MaximeChretien/HerbBox2.0/schematics/schematics.pdf

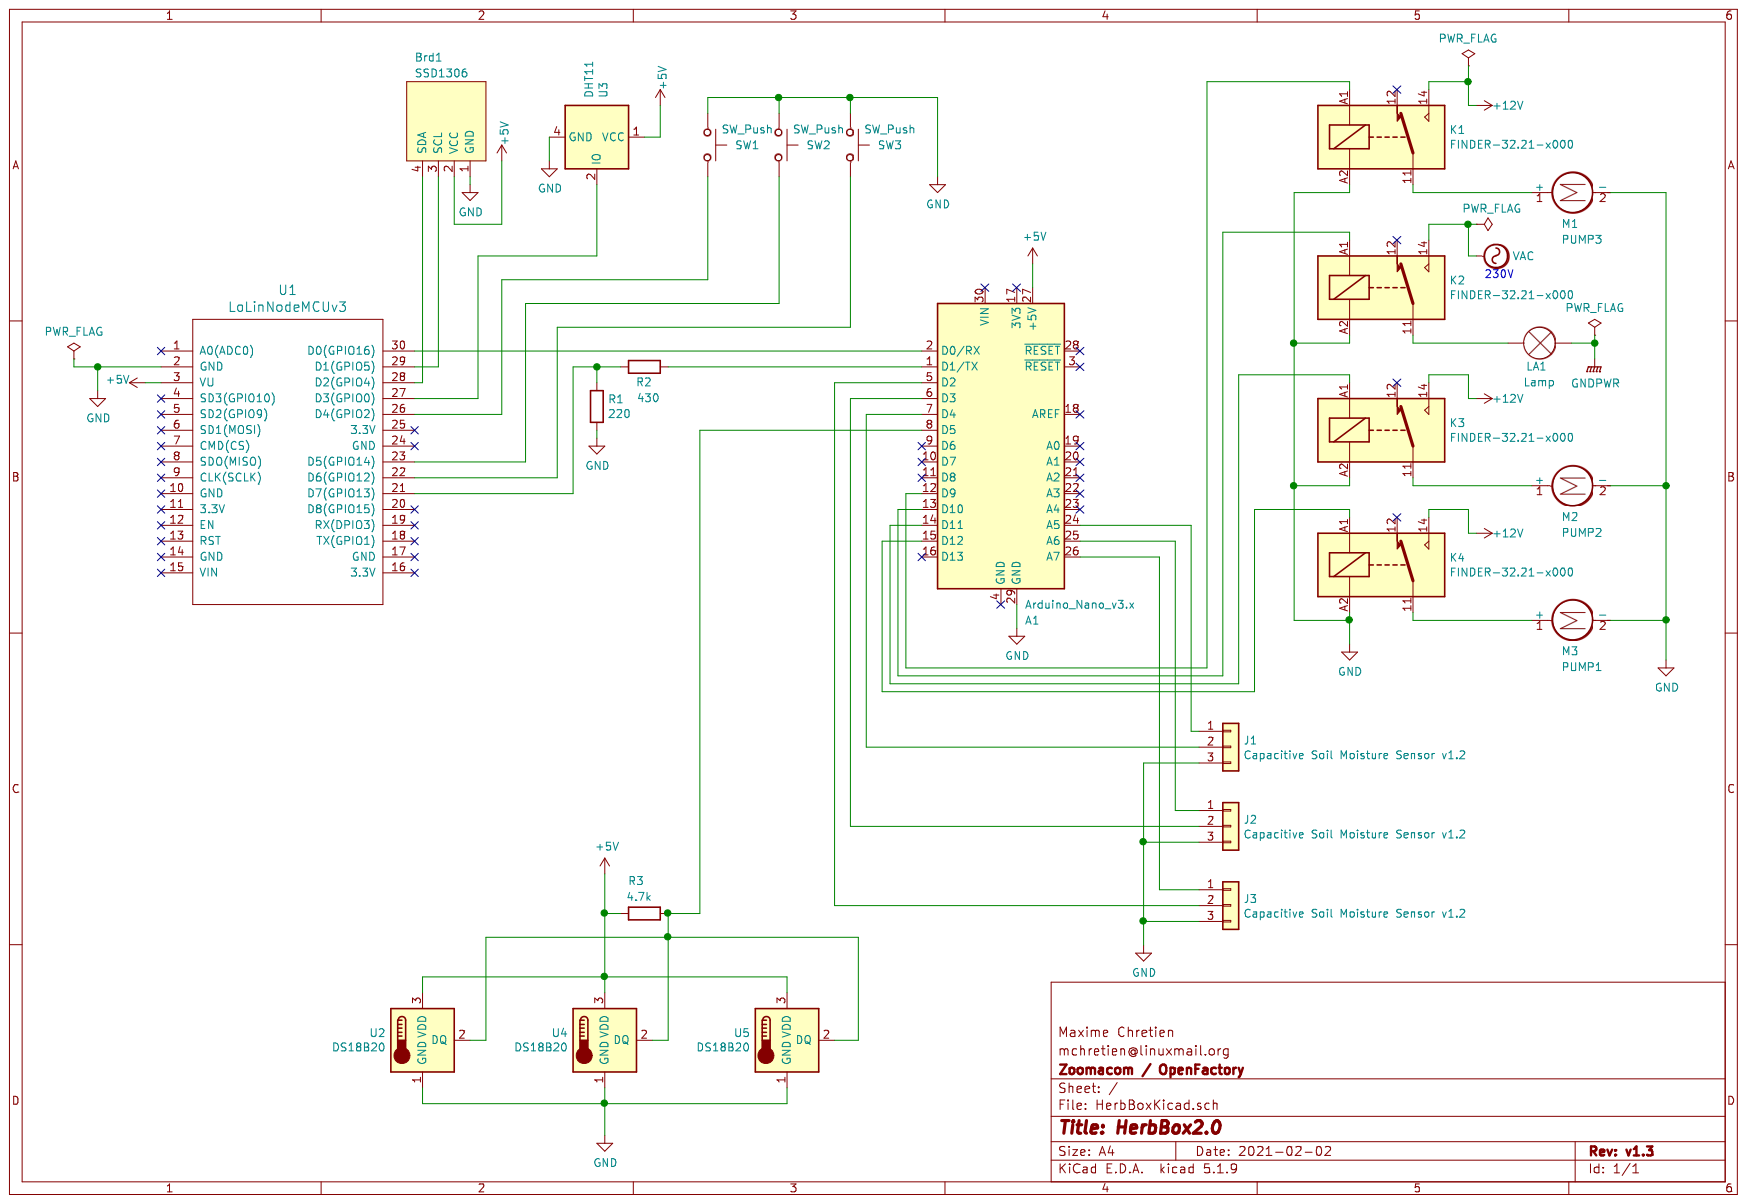
[picture p4: page 1]
