MaximeChretien/HerbBox2.0/src/ArduinoNano/sensors.h

/*
 *    @author  : Maxime Chretien (MixLeNain) && Zoomacom / OpenFactory
 *    @mail    : mchretien@linuxmail.org
 *    @project : HerbBox 2.0
 *    @summary : Defines of functions used to control the sensors.
 *    @version : 1.0
 */

void initSensors();
void updateTempSensors();
void updateHumSensors();

float getSoilTemp(int nb);
float getSoilHum(int nb);
