MaximeChretien/HerbBox2.0/src/NodeMCU/serialCom.ino

/*
 *    @author  : Maxime Chretien (MixLeNain) && Zoomacom / OpenFactory
 *    @mail    : mchretien@linuxmail.org
 *    @project : HerbBox 2.0
 *    @summary : Implementation of functions used to control the serial communication
 *		between the two microcontrollers.
 *    @version : 1.0
 */

#include "serialCom.h"

#include <SoftwareSerial.h>

// Init SoftwareSerial lines
SoftwareSerial SerialCom(D7,D0);

bool lampState;
bool tempLampState;
bool pumpState[3];
bool tempPumpState[3];
float soilTemp[3];
float soilHum[3];

void initSerial() {
	// Start Serial
	SerialCom.begin(9600);

	// Reset all variables
	lampState = false;
	for (int i = 0; i < 3; i++) {
		pumpState[i] = false;
		soilTemp[i] = 0;
		soilHum[i] = 0;
	}
}

void getSerialSensors() {
	int startIndex, endIndex;

	// Request values
	SerialCom.print("SE");

	// Result formating : S(P1)(P2)(P3)(L)#(T1)#(T2)#(T3)#(H1)#(H2)#(H3)E
	// Px : Pump number x state (0 or 1)
	// L : Lamp state (0 or 1)
	// Tx : Soil temperature number x (float value)
	// Hx : Soil humidity number x (float value)
	String result = SerialCom.readStringUntil('E');

	if (result.charAt(0) != 'S')
		return;

	// Split every values and store them in the corresponding variables
	for (int i = 0; i < 3; i++) {
		tempPumpState[i] = result.substring(i+1, i+2).toInt();
	}

	tempLampState = result.substring(4,5).toInt();

	startIndex = result.indexOf('#') + 1;
	endIndex = result.indexOf('#', startIndex);

	soilTemp[0] = result.substring(startIndex, endIndex).toFloat();

	startIndex = endIndex + 1;
	endIndex = result.indexOf('#', startIndex);

	soilTemp[1] = result.substring(startIndex, endIndex).toFloat();

	startIndex = endIndex + 1;
	endIndex = result.indexOf('#', startIndex);

	soilTemp[2] = result.substring(startIndex, endIndex).toFloat();

	startIndex = endIndex + 1;
	endIndex = result.indexOf('#', startIndex);

	soilHum[0] = result.substring(startIndex, endIndex).toFloat();
	soilHum[0] = map(soilHum[0], 780, 317, 0, 100);

	startIndex = endIndex + 1;
	endIndex = result.indexOf('#', startIndex);

	soilHum[1] = result.substring(startIndex, endIndex).toFloat();
	soilHum[1] = map(soilHum[1], 780, 317, 0, 100);

	startIndex = endIndex + 1;

	soilHum[2] = result.substring(startIndex).toFloat();
	soilHum[2] = map(soilHum[2], 780, 317, 0, 100);

	// Make sure the results are correct
	checkResults();
}

void setSerialPump(int nb, bool state) {
	pumpState[nb] = state;
	// Send a request to change the pump state
	SerialCom.print("P" + String(nb) + String(state) + "E");
}

void setSerialLamp(bool state) {
	lampState = state;
	// Send a resquet to change the lamp state
	SerialCom.print("L" + String(state) + "E");
}

void checkResults() {
	// If lamp state is not good, send a request to change it
	if (tempLampState != lampState) {
		setSerialLamp(lampState);
	}

	for (int i = 0; i < 3; i++) {
		// If pump state is not good, send a request to change it
		if (tempPumpState[i] != pumpState[i]) {
			setSerialPump(i, pumpState[i]);
		}

		// In case of a communication error, the values are set to 0
		// so we give them the values of the air
		// while waiting for a good value from the Serial line
		if (soilTemp[i] == 0.0) {
			soilTemp[i] = airTemp;
		}

		if (soilHum[i] == 0.0) {
			soilHum[i] = airHum;
		}
	}

}

float getSerialSoilTemp(int nb) {
	return soilTemp[nb];
}

float getSerialSoilHum(int nb) {
	return soilHum[nb];
}

bool getSerialPump(int nb) {
	return pumpState[nb];
}

bool getSerialLamp() {
	return lampState;
}
