MaximeChretien/HerbBox2.0/(commit log)

2021-01-18 First commit
    Base files are here and the NodeMCU sensors and display are working
2021-01-19 NodeMCU : Improve Serial
    There is still some problem to get soil humidity but everything else
    works
    [NodeMCU.ino, display.ino, serialCom.ino]
2021-01-19 Add Arduino Nano part
    There seems to be a problem to read temperature sensors (they always
    send 85°C)
    [ArduinoNano.ino, constants.h, relays.h, relays.ino, sensors.h, sensors.ino, serialCom.h, serialCom.ino]
2021-01-19 AduinoNano : Remove humidity remap and add temperature requests
2021-01-19 NodeMCU : Fix Serial communications decoding
    [serialCom.ino]
2021-01-20 Release 1.0
    - Add Blynk support
    - Add auto control
    - Format soil humidity properly
    - Display all values on the screen using one menu for each plant
    - Improve manual control for each plant
    - Set soil humidity and temperature to air values if the ArduinoNano
    return 0 (this is usefull at startup)
2021-02-01 NodeMCU : Use SoftwareSerial for communications
    This avoids conflicts when uploading a new program to the NodeMCU and
    thus removes the need to disconnect the serial line when uploading an
    updated code.
    It is still needed to disconnect the line when uploading to the Arduino
    Nano but since the NodeMCU is the only one who needs to be updated to
    change the automatic control parameters, the Arduino Nano shouldn't have
    to be reprogrammed once everything is in place.
    [serialCom.ino]
2021-02-01 Add Kicad schematics
    [HerbBoxKicad.kicad_pcb, HerbBoxKicad.sch]
2021-02-01 NodeMCU : Move TX line from D8 to D0
    D8 needs to be low when booting but the Arduino Nano pull it high so the
    NodeMCU doesn't boot properly when the TX line is connected. Using pin
    D0 leaves D8 free when booting and allows everything to work properly.
    [HerbBoxKicad.sch]
2021-02-01 Schematics: Add png copy of the pdf
2021-02-01 Rename Schematics folder to schematics
    [HerbBoxKicad.kicad_pcb, HerbBoxKicad.sch]
2021-02-02 Arduino Nano : Move OneWire bus to pin 5
    This also moves the moisture sensors alimentation pins to 2, 3 and 4
    instead of 3, 4 and 5.
    [HerbBoxKicad.sch]
2021-02-02 NodeMCU : Invert Pump and Lamp pin
    [constants.h]
2021-03-23 NodeMCU: Update blynk init
    - This allows to use the system without blynk, it doesn't block the
    system anymore when the connection doesn't work
    - Use the port 8080 of blynk servers since port 80 doesn't seem to work
    properly
    [blynk.ino]
